cjlux/Banc-Mesure-Rotor/Docs/Images/Calibration-Magnet.png

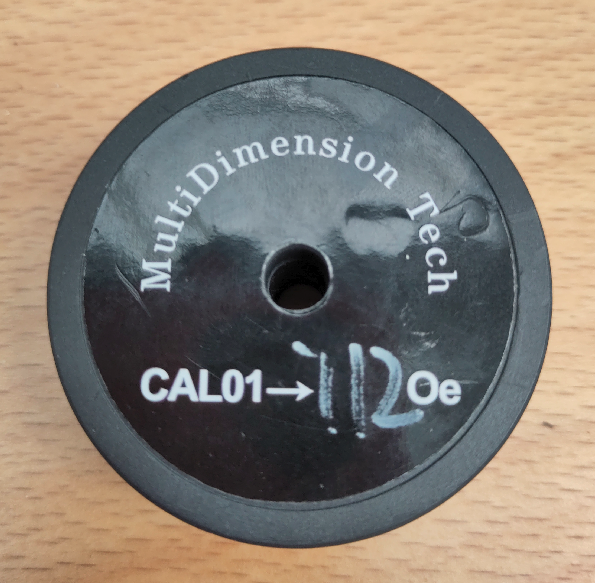
Docs/Images/Calibration-Magnet.png
