cjlux/Banc-Mesure-Rotor/Docs/Images/ROTOR_bench_overall-2.png

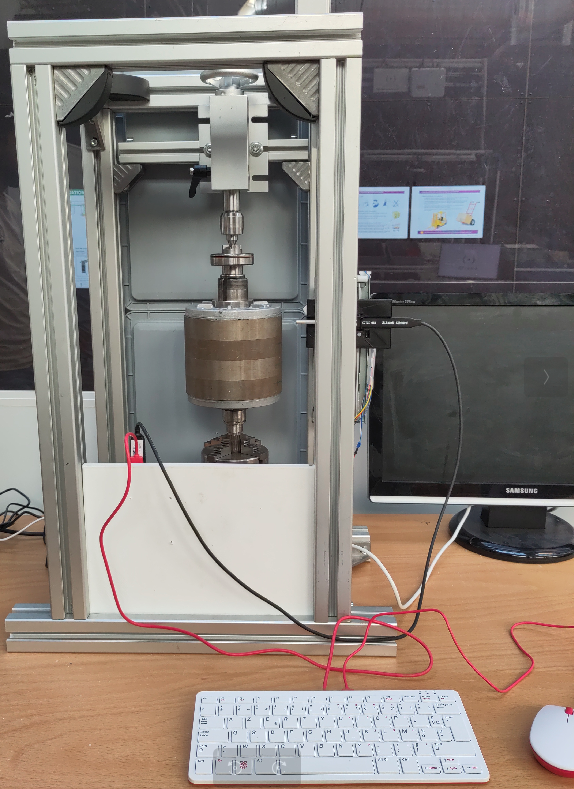
Docs/Images/ROTOR_bench_overall-2.png
