cjlux/Banc-Mesure-Rotor/README.md

# Banc-Mesure-Rotor
Banc de mesure du champ magnétique d'un rotor de moteur électrique
