cjlux/Banc-Mesure-Rotor/Docs/USB25103/USBMagV4.0.2/COM Port Optimizer Utility/Readme.txt

If the USB magnetometer driver is automatically installed by Microsoft Windows, it will be set to the default values specified by FTDI.  Run this utility to set the proper port latency and buffer sizes for USB Magnetometer fast operation.
