cjlux/Banc-Mesure-Rotor/Docs/USB25103/USBMagV4.0.2/Firmware/Three-axis/readme.txt

This firmware works for both Hall three-axis probes and TMR three-axis probes.
