cjlux/Banc-Mesure-Rotor/Docs/Sondes magnétiques.odt

Capteurs magnétiques / MULTI DIMENSION (MT)

https://www.dowaytech.com/en/sensor/usb_magnetometer.html

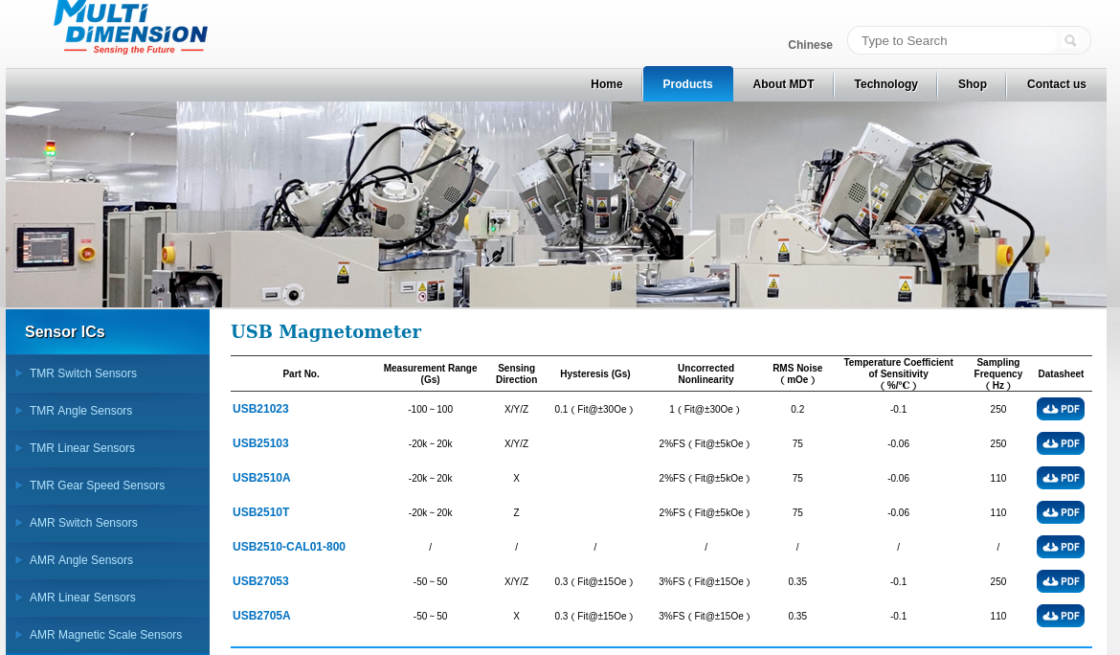
[picture p3: figure]
