cjlux/Banc-Mesure-Rotor/Docs/2024-11-19-15-50-06-532.jpg

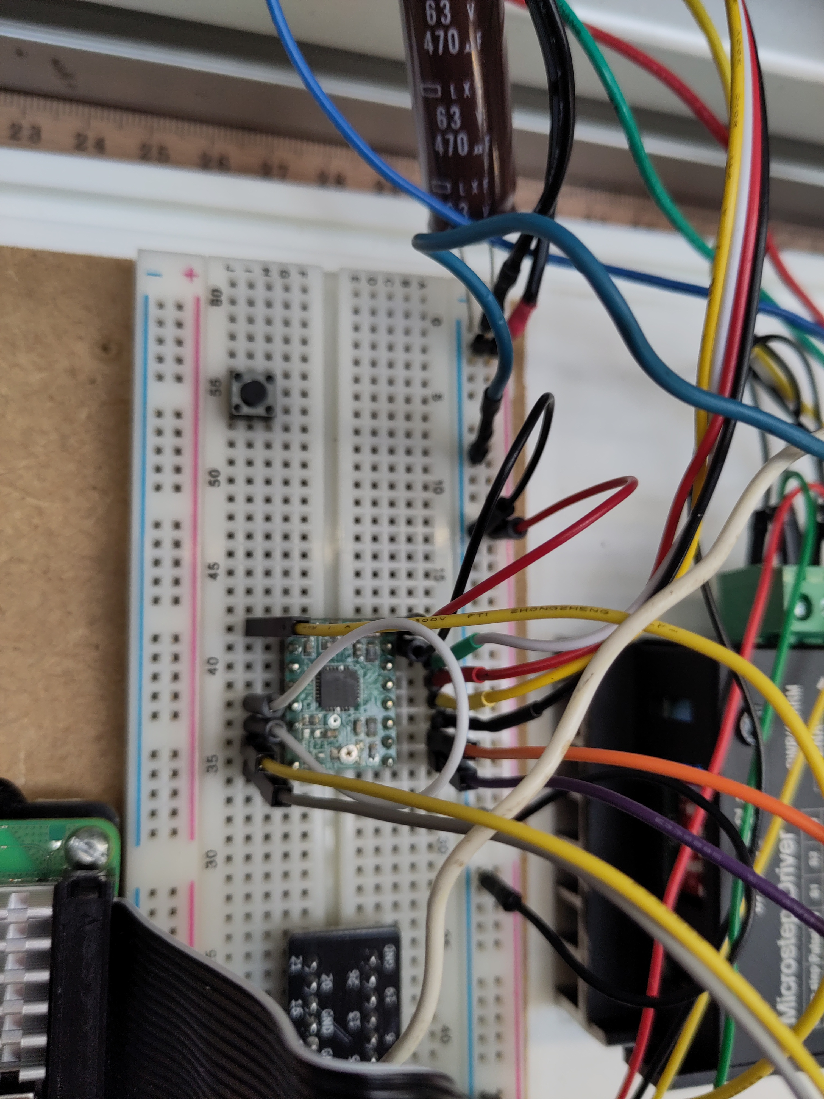
Docs/2024-11-19-15-50-06-532.jpg
