cjlux/Banc-Mesure-Rotor/Docs/2024-11-19-15-50-18-695.jpg

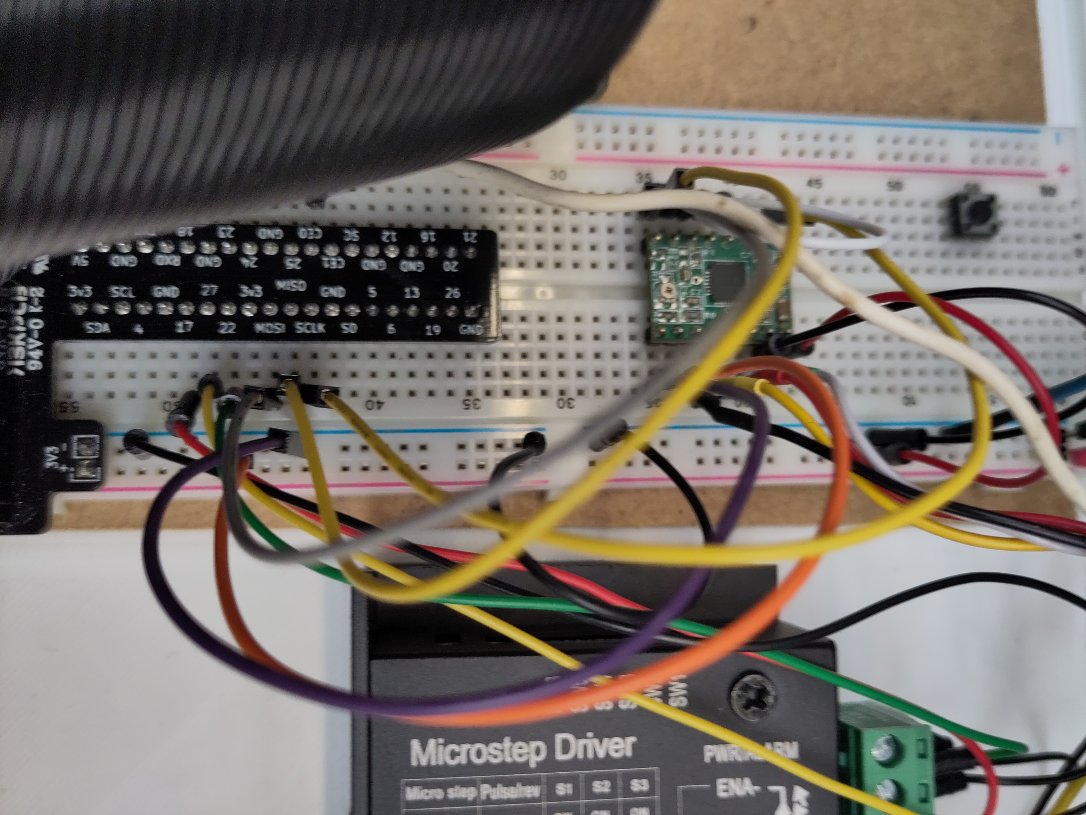
Docs/2024-11-19-15-50-18-695.jpg
