cjlux/Banc-Mesure-Rotor/Docs/2024-11-19-15-50-46-090.jpg

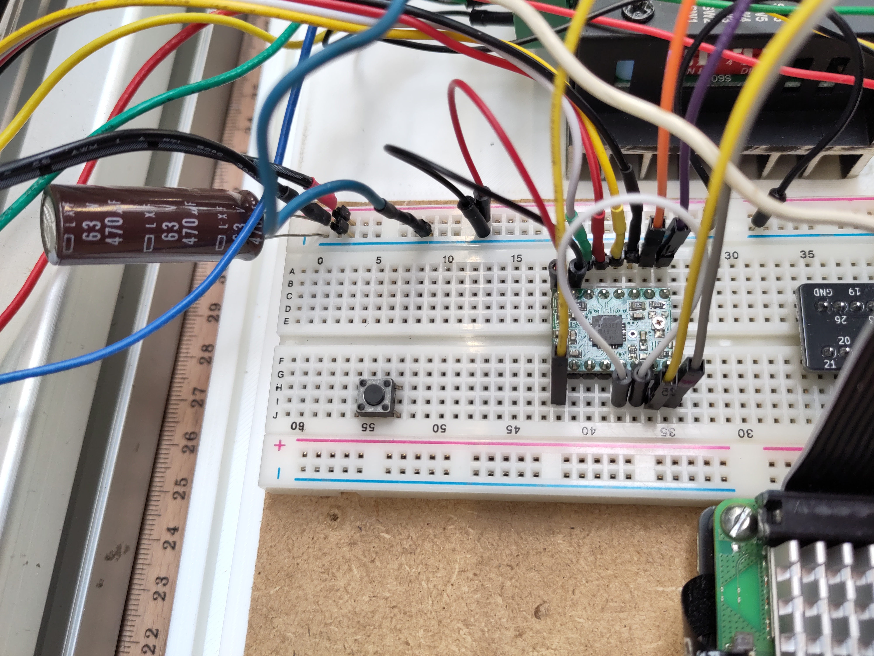
Docs/2024-11-19-15-50-46-090.jpg
