cjlux/Banc-Mesure-Rotor/Docs/2024-11-19-15-50-53-892.jpg

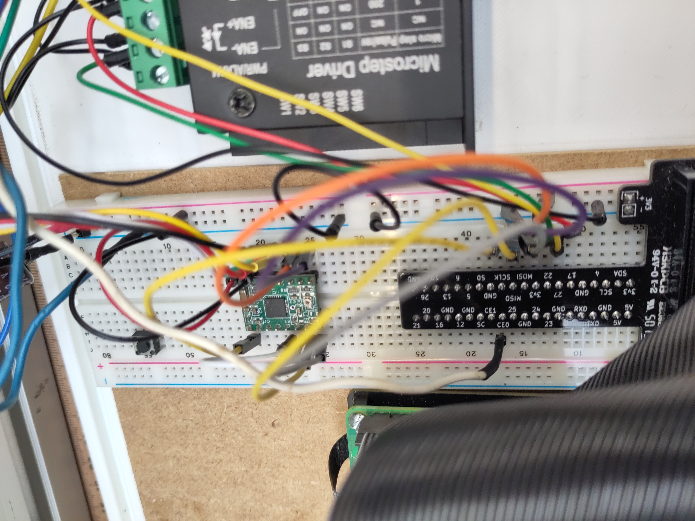
Docs/2024-11-19-15-50-53-892.jpg
