cjlux/Banc-Mesure-Rotor/Docs/Images/A4988.png

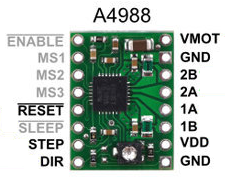
Docs/Images/A4988.png
