cjlux/Banc-Mesure-Rotor/Docs/Images/BlocMandrinXontrepointe.png

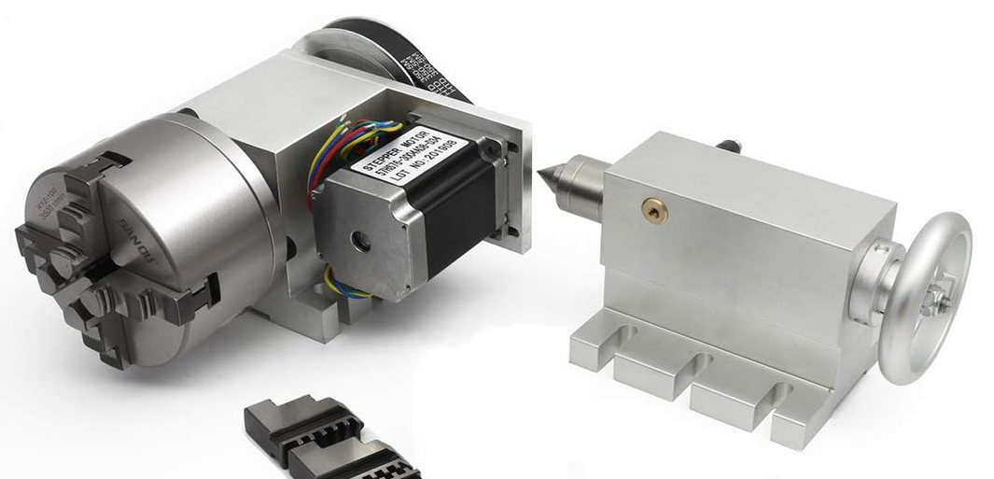
Docs/Images/BlocMandrinXontrepointe.png
