cjlux/Banc-Mesure-Rotor/Docs/Images/Chuck.png

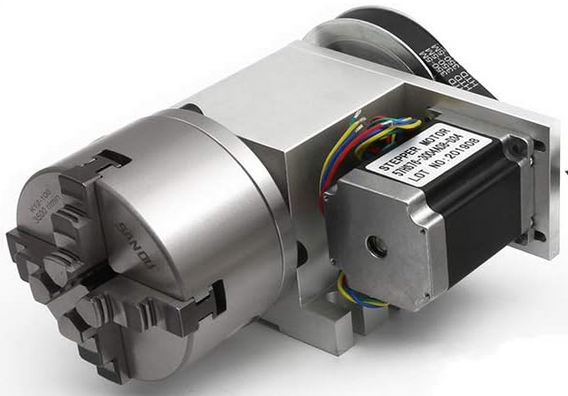
Docs/Images/Chuck.png
