cjlux/Banc-Mesure-Rotor/Docs/Images/Flowchart-1_2.png

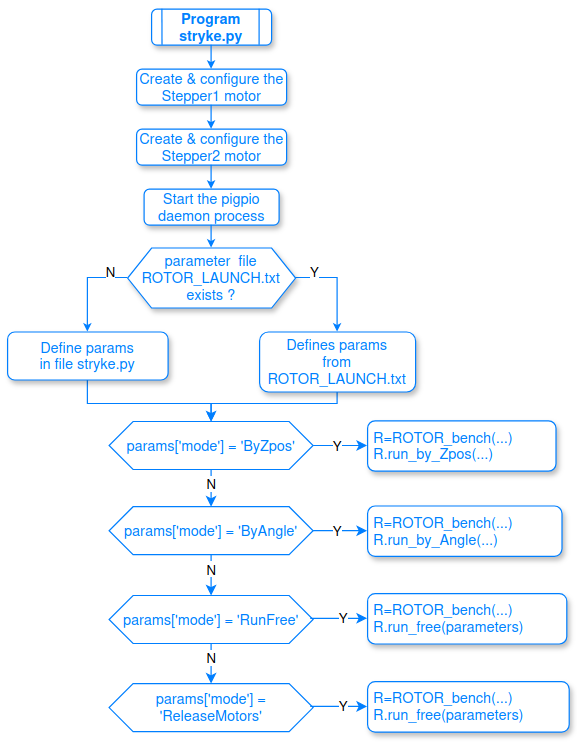
Docs/Images/Flowchart-1_2.png
