cjlux/Banc-Mesure-Rotor/Docs/Images/GUI-1_2.png

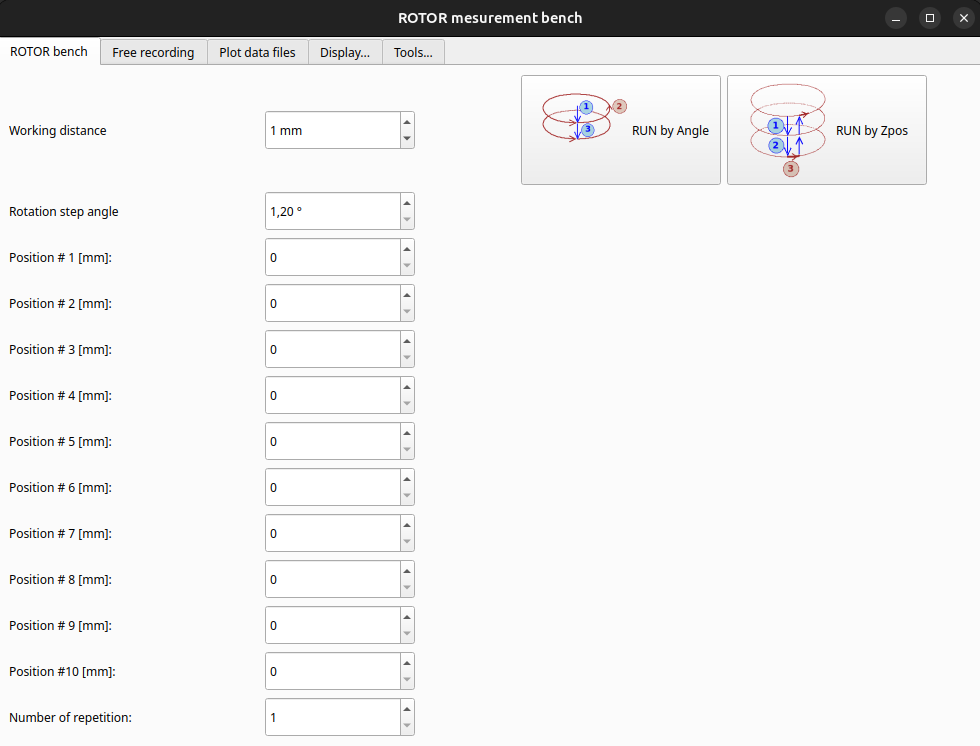
Docs/Images/GUI-1_2.png
