cjlux/Banc-Mesure-Rotor/Docs/Images/GUI-2.png

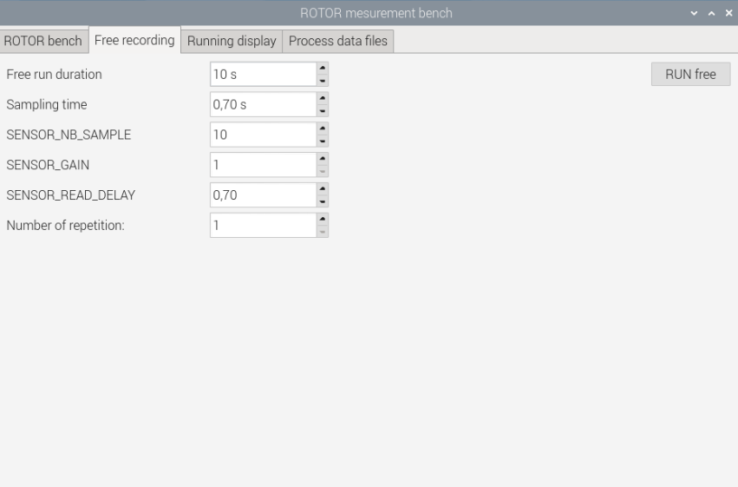
Docs/Images/GUI-2.png
