cjlux/Banc-Mesure-Rotor/Docs/Images/GUI-3-2.png

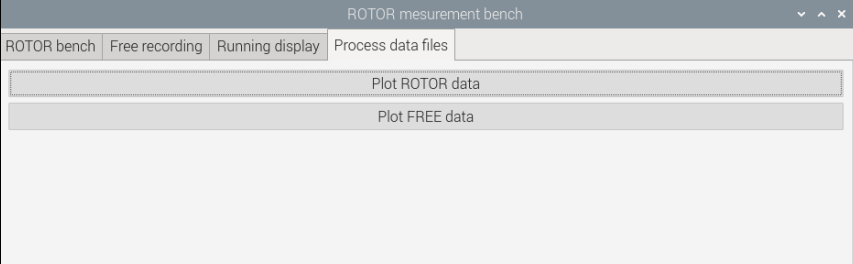
Docs/Images/GUI-3-2.png
