cjlux/Banc-Mesure-Rotor/Docs/Images/GUI-3-2_2.png

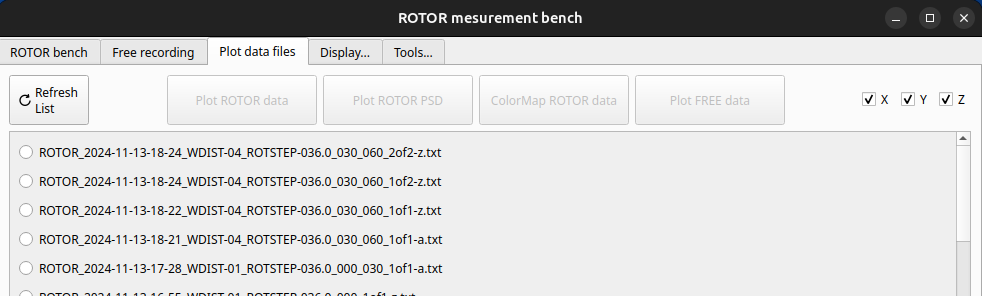
Docs/Images/GUI-3-2_2.png
