cjlux/Banc-Mesure-Rotor/Docs/Images/GUI-3.png

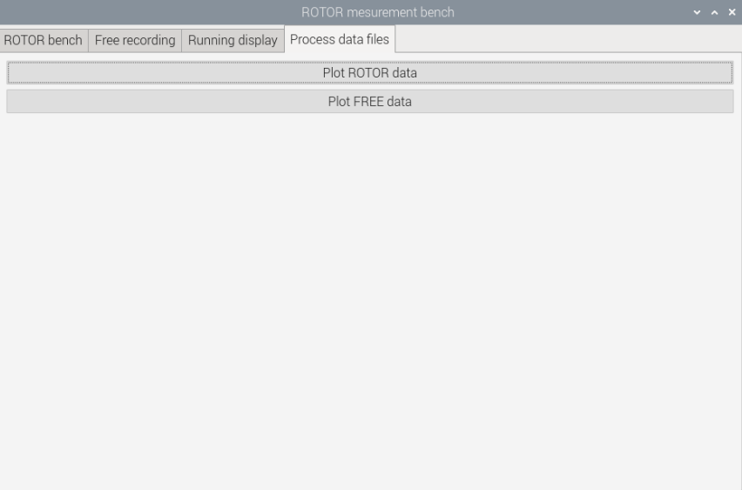
Docs/Images/GUI-3.png
