cjlux/Banc-Mesure-Rotor/Docs/Images/GUI_exple_plot_CMAP.png

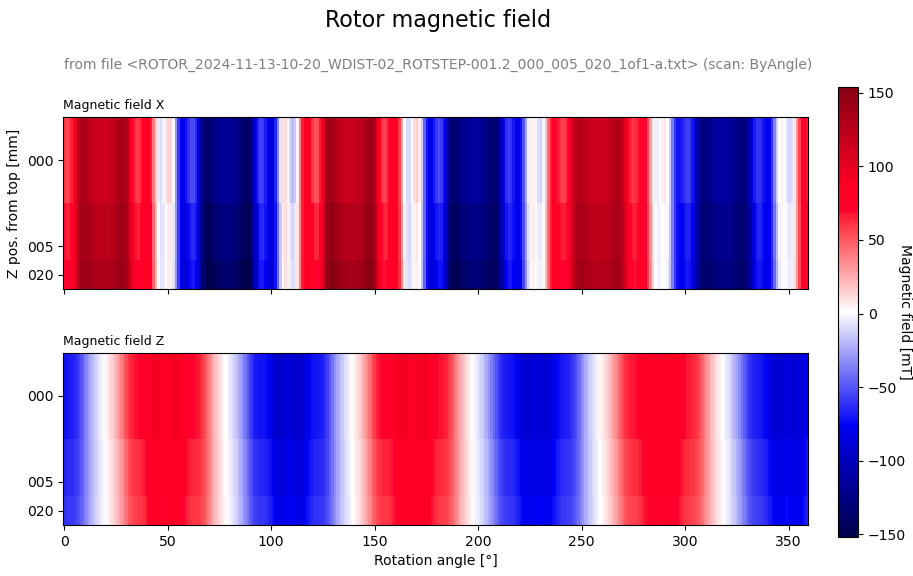
Docs/Images/GUI_exple_plot_CMAP.png
