cjlux/Banc-Mesure-Rotor/Docs/Images/GUI_exple_plot_PSD.png

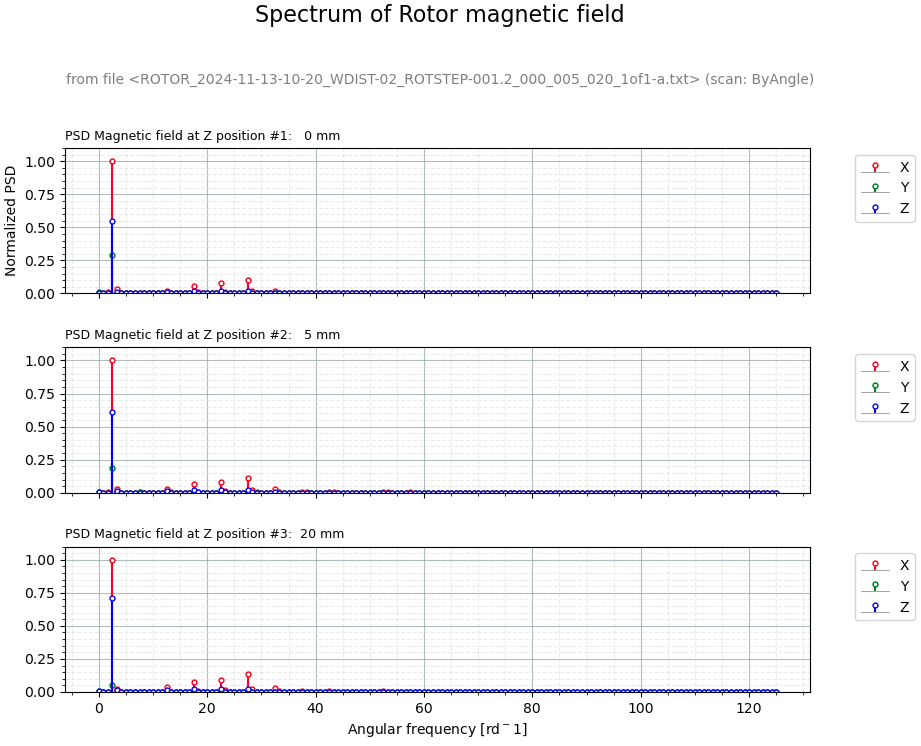
Docs/Images/GUI_exple_plot_PSD.png
