cjlux/Banc-Mesure-Rotor/Docs/Images/GUI_exple_plot_ROTOR.png

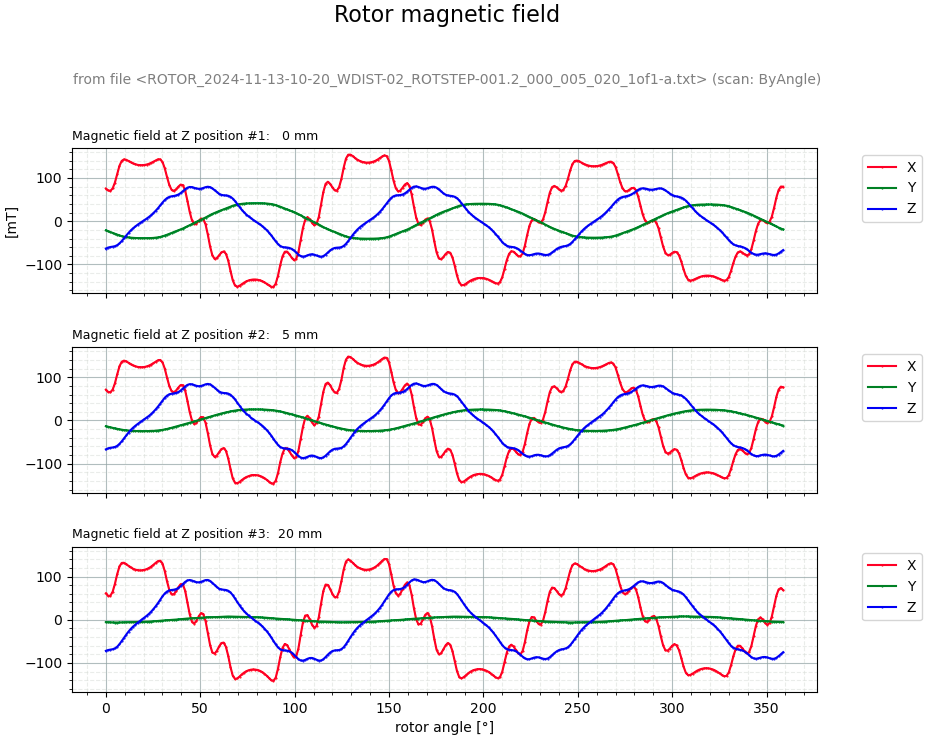
Docs/Images/GUI_exple_plot_ROTOR.png
