cjlux/Banc-Mesure-Rotor/Docs/Images/GUI_plot-FREE.png

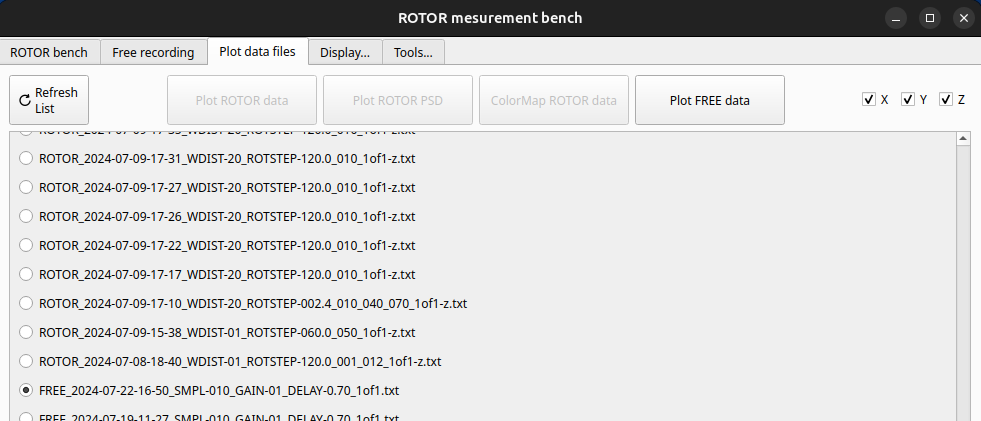
Docs/Images/GUI_plot-FREE.png
