cjlux/Banc-Mesure-Rotor/Docs/Images/GUI_plot-ROTOR.png

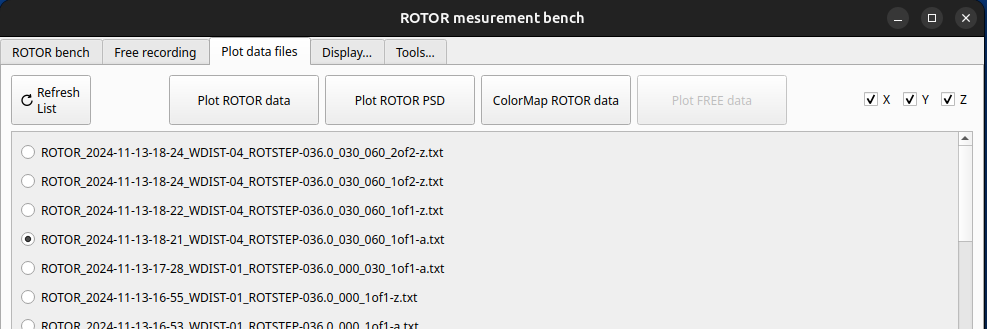
Docs/Images/GUI_plot-ROTOR.png
