cjlux/Banc-Mesure-Rotor/Docs/Images/Kit-PIMM699-2.png

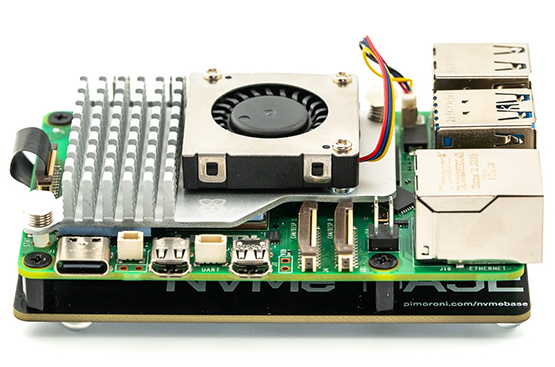
Docs/Images/Kit-PIMM699-2.png
