cjlux/Banc-Mesure-Rotor/Docs/Images/Kit-PIMM699-3.png

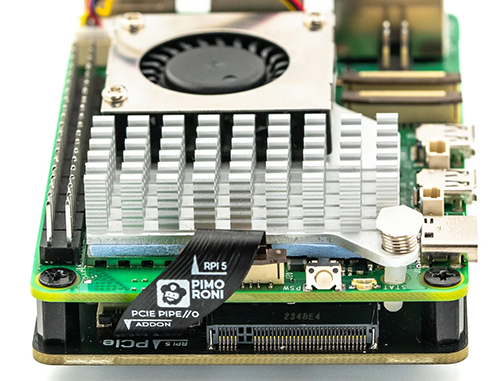
Docs/Images/Kit-PIMM699-3.png
