cjlux/Banc-Mesure-Rotor/Docs/Images/Kit-PIMM699.png

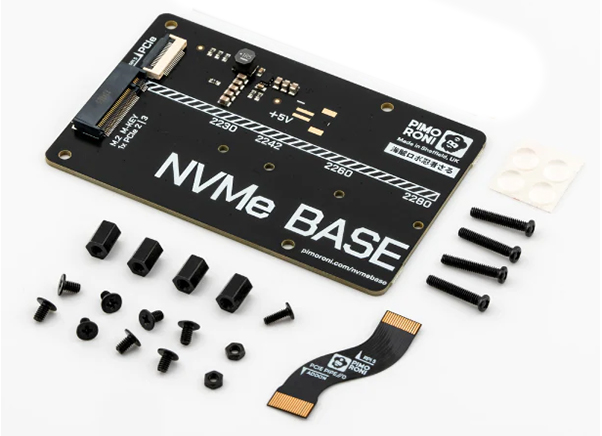
Docs/Images/Kit-PIMM699.png
