cjlux/Banc-Mesure-Rotor/Docs/Images/NEMA14.png

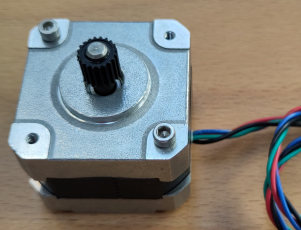
Docs/Images/NEMA14.png
