cjlux/Banc-Mesure-Rotor/Docs/Images/NEMA24.png

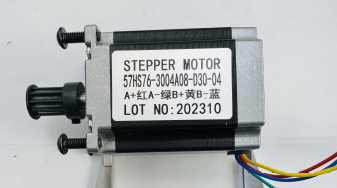
Docs/Images/NEMA24.png
