cjlux/Banc-Mesure-Rotor/Docs/Images/Plot_ROTOR.png

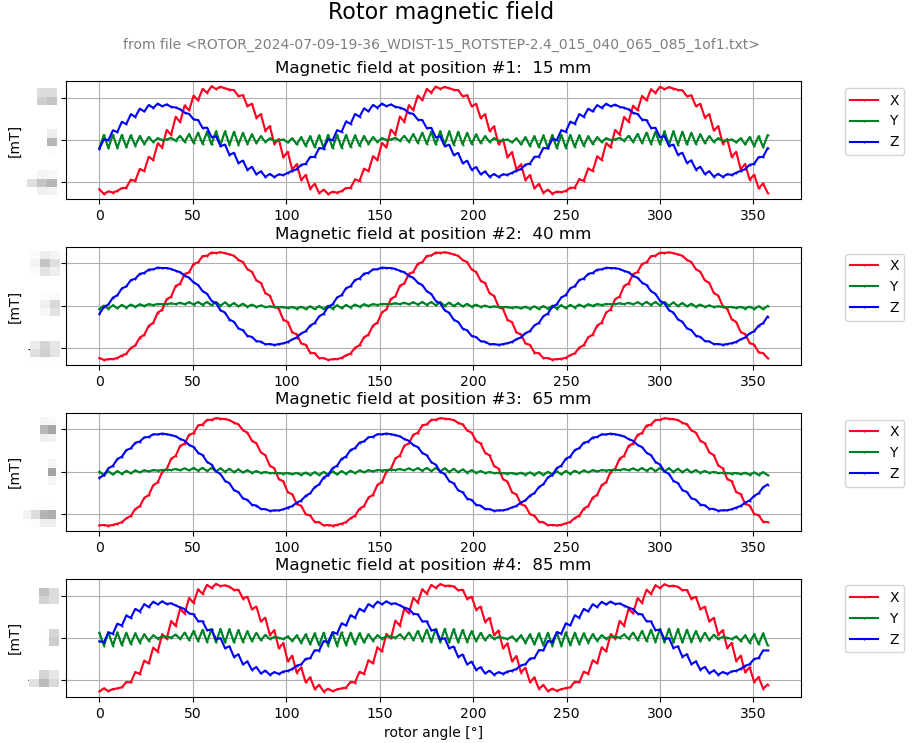
Docs/Images/Plot_ROTOR.png
