cjlux/Banc-Mesure-Rotor/Docs/Images/ROTOR_2024-11-07-17-33_WDIST-01_ROTSTEP-001.2_000_060_1of1-a_CMAP_XZ.png

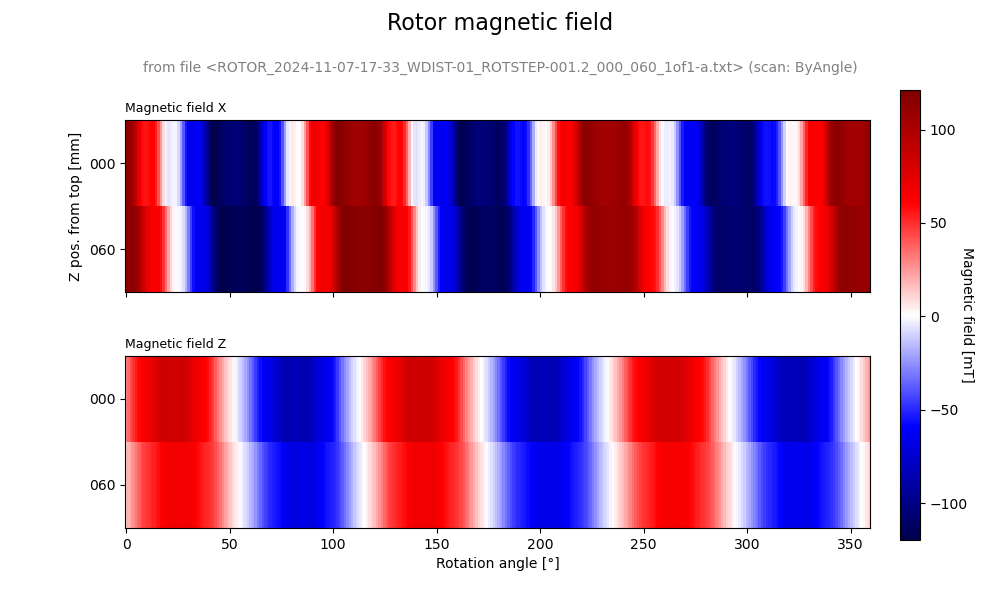
Docs/Images/ROTOR_2024-11-07-17-33_WDIST-01_ROTSTEP-001.2_000_060_1of1-a_CMAP_XZ.png
