cjlux/Banc-Mesure-Rotor/Docs/Images/ROTOR_bench-4.png

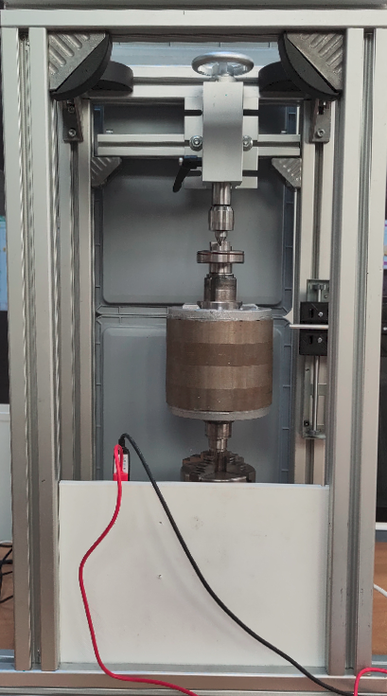
Docs/Images/ROTOR_bench-4.png
