cjlux/Banc-Mesure-Rotor/Docs/Images/ROTOR_bench_overall-1.png

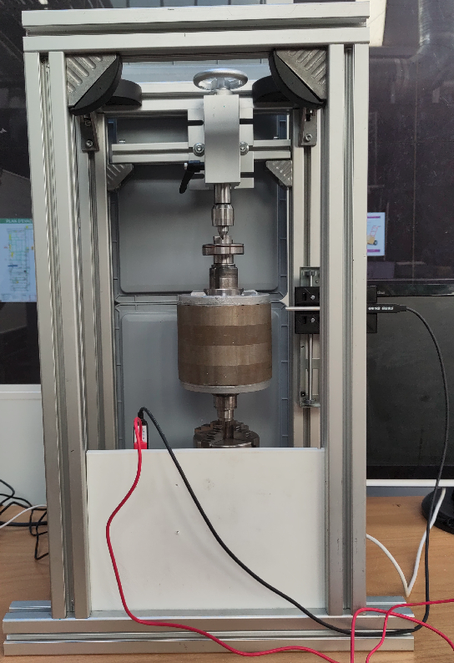
Docs/Images/ROTOR_bench_overall-1.png
