cjlux/Banc-Mesure-Rotor/Docs/Images/ROTOR_in_Chuck.png

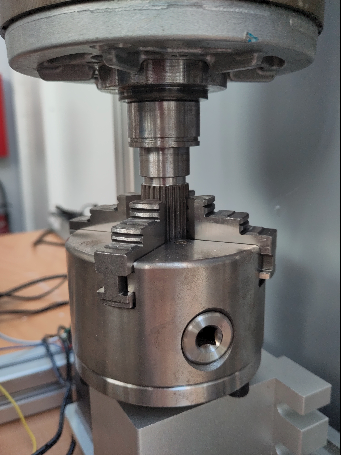
Docs/Images/ROTOR_in_Chuck.png
