cjlux/Banc-Mesure-Rotor/Docs/Images/ROTOR_in_Tailstock.png

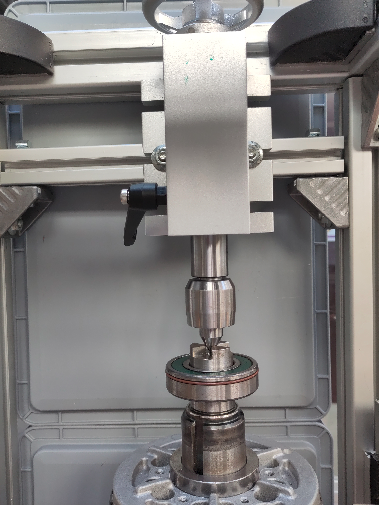
Docs/Images/ROTOR_in_Tailstock.png
