cjlux/Banc-Mesure-Rotor/Docs/Images/RPI4-plate.png

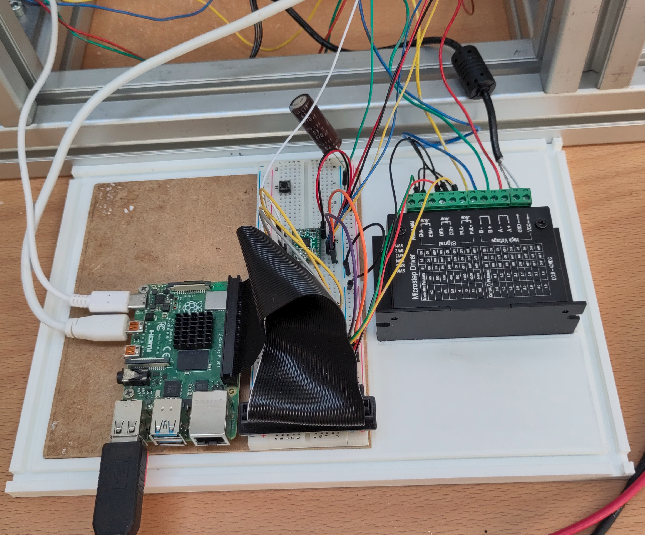
Docs/Images/RPI4-plate.png
