cjlux/Banc-Mesure-Rotor/Docs/Images/Sensor_Plate-1.png

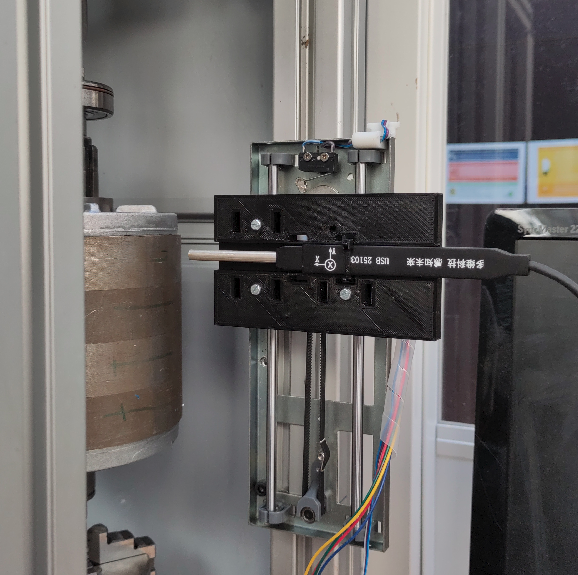
Docs/Images/Sensor_Plate-1.png
