cjlux/Banc-Mesure-Rotor/Docs/Images/Sensor_Plate-3.png

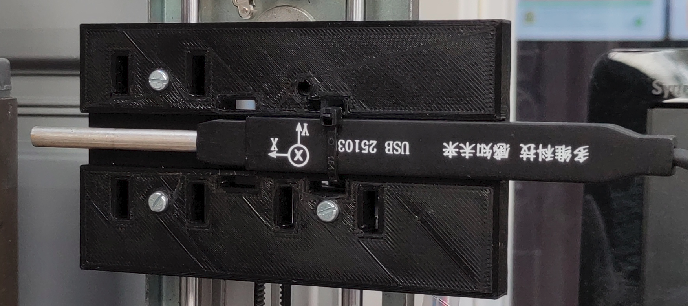
Docs/Images/Sensor_Plate-3.png
