cjlux/Banc-Mesure-Rotor/Docs/Images/Stepper-NAMA14.png

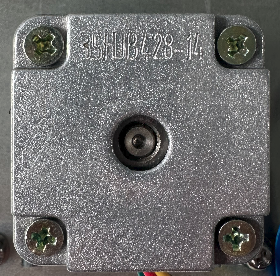
Docs/Images/Stepper-NAMA14.png
