cjlux/Banc-Mesure-Rotor/Docs/Images/Synoptic.png

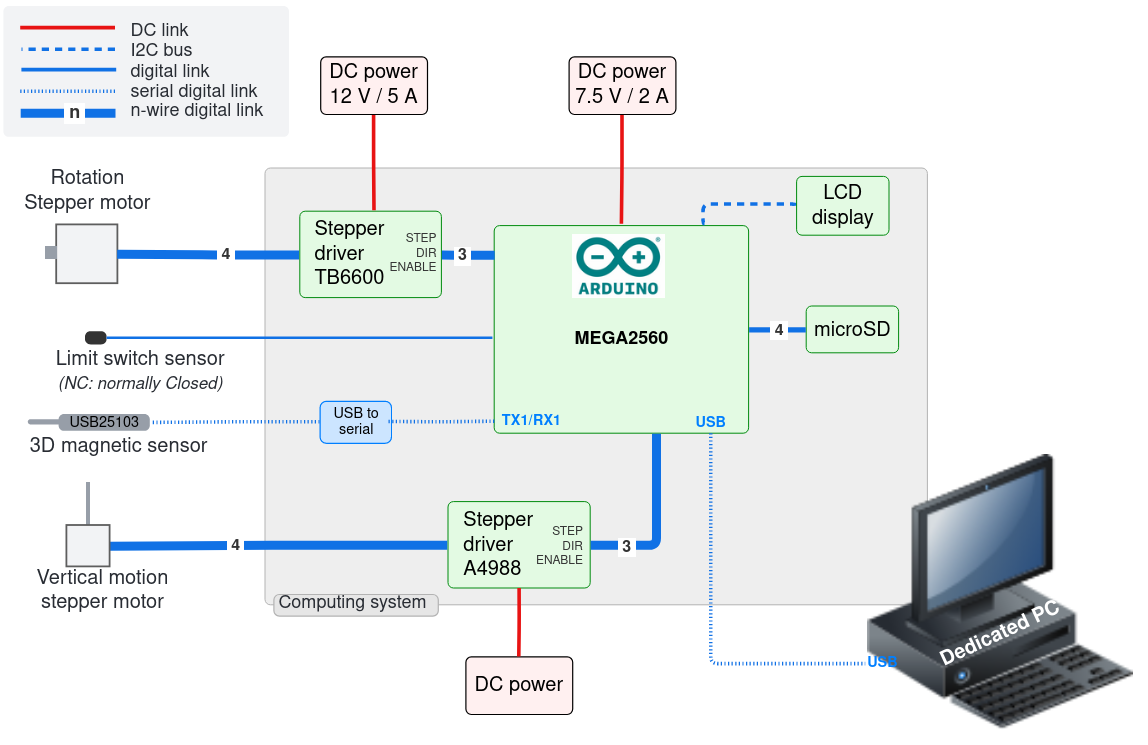
Docs/Images/Synoptic.png
