cjlux/Banc-Mesure-Rotor/Docs/Images/tailstock.png

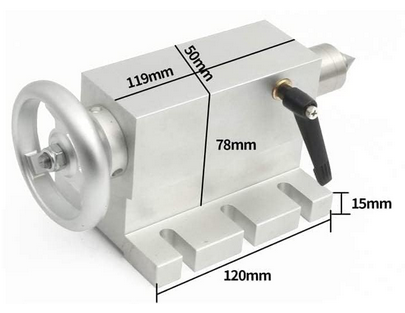
Docs/Images/tailstock.png
