cjlux/Banc-Mesure-Rotor/Docs/Images/USB25103.png

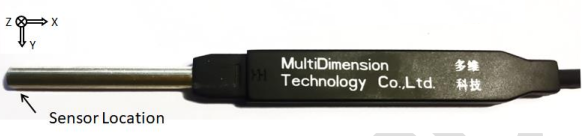
Docs/Images/USB25103.png
