cjlux/Banc-Mesure-Rotor/Docs/Images/USB27103-calib-axiale.png

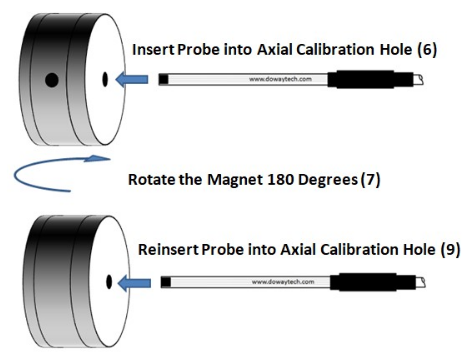
Docs/Images/USB27103-calib-axiale.png
