cjlux/Banc-Mesure-Rotor/Docs/Images/USB27103-calib-transverse.png

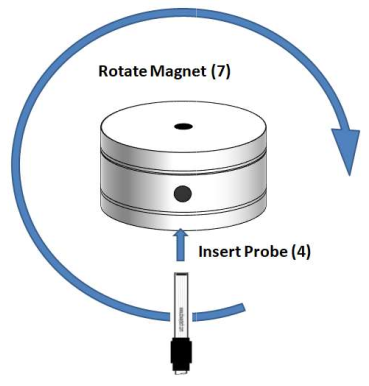
Docs/Images/USB27103-calib-transverse.png
