cjlux/Banc-Mesure-Rotor/Docs/Images/Zoom_NEMA14_connexion.png

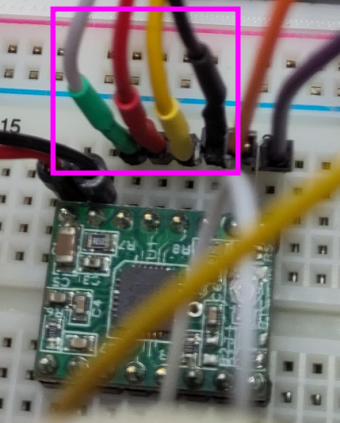
Docs/Images/Zoom_NEMA14_connexion.png
