cjlux/Banc-Mesure-Rotor/Docs/CAO/OverallPlate.FCStd

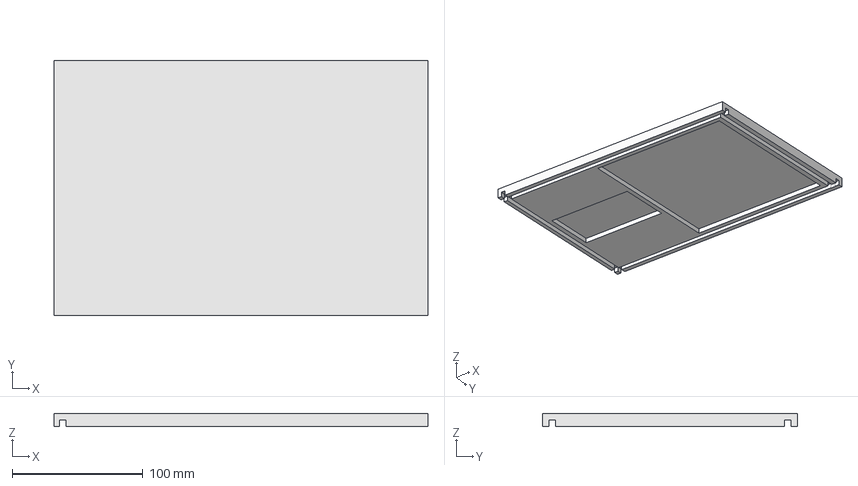
[picture p156: CAD file, 2024-07-17]
Docs/CAO/OverallPlate.FCStd
286.0 x 195.0 x 10.0 mm
