cjlux/Banc-Mesure-Rotor/Docs/CAO/MagneticProbePlate.FCStd

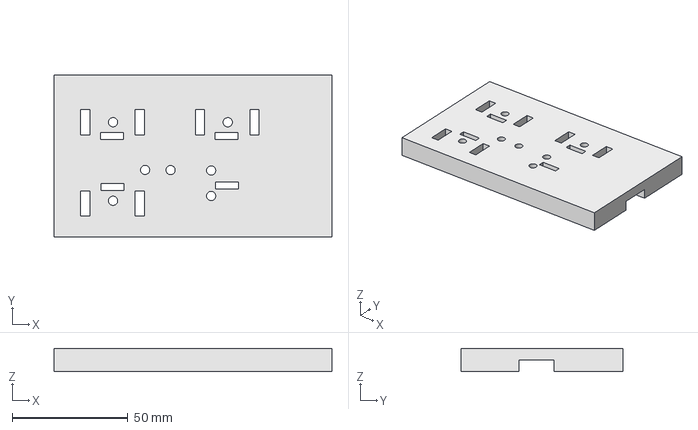
[picture p157: CAD file, 2024-07-17]
Docs/CAO/MagneticProbePlate.FCStd
120.0 x 70.0 x 10.0 mm
