cjlux/Banc-Mesure-Rotor/Old/Arduino_version/ProgTestArduino/Readme.md

Arduino demo code :
- LCD-I2C_16x2: (UNO & MEGA)elementary program do write data on the LCD display.
- RTC_LCD: (UNO & MEGA) Basic usage of the Real Time Clock module to display date & current time on the LCD display.
- MEGA_RTC_LCD_SD: (MEGA) Basic usage of the Real Time Clock to display date & current time on the LCD display plus create and write data file on the micro SD card.
- MEGA_RTC_LCD_SD_PAP: (MEGA) idem previous programm + driving the stepper mortor.
- stepperMotor_test : (UNO) test of a stepper motor with DIR, STEP & ENABLE signals.
- Test_Ref_Z_SteperMotor : (UNO & MEGA) Test Z motion with steeper motor on many Z positions.
- Test_Z_StepperMotor: (UNO & MEGA) Test Z motion with supward to reach the contact with the limit siwtch sensor.
- Tiny_RTC: (ANY) elementatry program to use the Real Time Clock module.
- UNO_PAP: (UNO) Test of the ROTOR stepper motor
- UNO_SD-CardInfo: (UNO) Display info on the SD card reader.
- UNO_SD-Files: (UNO) play with files on the SD card.
- UNO_SD-listfiles: (UNO) list files on the SD card.
- UNO_SD-ReadWrite: (UNO) elementatry program to read/write files on the SD card.
