cjlux/Banc-Mesure-Rotor/Docs/Images/USB27103-calibration.png

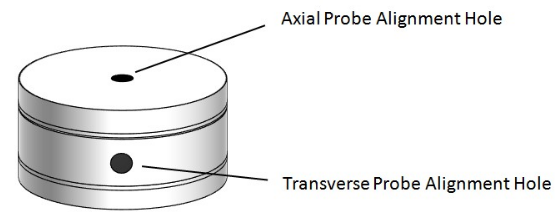
Docs/Images/USB27103-calibration.png
