cjlux/Banc-Mesure-Rotor/(list of files, drawings)

Other design files:
Docs/Diagrams/ElectricalScheme.fzz
