cjlux/Banc-Mesure-Rotor/ROTOR_bench/ROTOR_bench.py

#
# Copyright 2024-2025 Jean-Luc.CHARLES@mailo.com
#

import os
import numpy as np
import matplotlib.pyplot as plt
from serial import Serial
from time import sleep, time
from datetime import datetime
import sys, subprocess

import gpiod

from ROTOR_config import StepperMotor, Zaxis, Param
from Tools import uniq_file_name_ROTOR, uniq_file_name_FREE

class ROTOR_bench():

    def __init__(self, stepper1, stepper2, init_serial=True):

        self.stepper1 = stepper1    # the stepper motor for rotating the shaft
        self.stepper2 = stepper2    # the stepper motor for the sensorZ motion
        
        # GPIO in/out lines are defined in GPIOD_define_line() method:
        self.stepper1_DIR_line  = None
        self.stepper1_STEP_line = None
        self.stepper1_ENA_line  = None
        self.stepper2_DIR_line  = None
        self.stepper2_STEP_line = None
        self.stepper2_ENA_line  = None
        
        self.emergencyStopRequired = False
        self.serialPort = None      # The serial port connect to the USB link with the magnetic sensor.
        self.Z_pos_mm = []          # The list of the sensorZ positions, the first one is 0.
        
        # Instanciate the RPi GPIO driver with the 'gpiod' module:
        self.gpio_chip = gpiod.Chip('gpiochip4')

        self.GPIOD_define_lines()
        self.GPIOD_config_lines()
        self.GPIOD_init_lines()

        if init_serial:
            # open the seriallink with the sensor:
            self.open_Serial(5)
            if self.serialPort is None:
                print('[ERROR] cannot open any USB port, tchao!')
                sys.exit()

            # noww let's configure the magnetic sensor:
            ret = self.config_USBsensor()
            if ret !=0:
                print('[ERROR] while configuring the USBsensor, tchao!')
                sys.exit()
            else:
                print('[INFO] Sensor configuration OK')

            # Send someunused command to clean the serial buffer:
            self.serialPort.write(b'HI')
            sleep(1)
            self.serialPort.read_all()

            # Now get the sensor calibration data after the sensor calibration:
            self.serialPort.write(b'PC')
            sleep(1)
            data = self.serialPort.read_all().decode().replace('\r', '')
            print('[INFO] Configuration of the sensor USB25103:')
            print(data)
            self.calibration_data = '# ' + data.replace('\n', '\n# ') +'\n'

    def open_Serial(self, timeout:int = 1):
        '''
        To open the serial link to the magnetic sensor.
        '''
        listUSBports = ["/dev/ttyUSB0", "/dev/ttyUSB1"]
        serialPort = None
        for port in listUSBports:
            try:
                print(f"[INFO] Trying to open {port}")
                serialPort = Serial(port, baudrate=115200, timeout=timeout)
                break
            except:
                continue
        if serialPort is None:
            return
        self.serialPort = serialPort
        
        # read the magnetic sensor banner:
        sleep(3)
        data = self.serialPort.read_all().decode().strip()            
        print(f"[INFO] Found:\n{data}\n[INFO] Sound good !")

    def config_USBsensor(self):
        if self.serialPort is None:
            print('[ERROR] SeialPort is not opened, cannot configure the USBsensor')
            return -1
        self.serialPort.write(f"NS {Param['SENSOR_NB_SAMPLE']}".encode('ascii'))
        sleep(0.5)
        self.serialPort.write(f"PG {Param['SENSOR_GAIN']}".encode('ascii'))
        return 0
            
    def GPIOD_define_lines(self):
        ''' To define the needed RPi GPIO in/out lines.'''
        
        self.stepper1_DIR_line  = self.gpio_chip.get_line(self.stepper1.GPIO_DIR)
        self.stepper1_STEP_line = self.gpio_chip.get_line(self.stepper1.GPIO_STEP)
        self.stepper1_ENA_line  = self.gpio_chip.get_line(self.stepper1.GPIO_ENA)

        self.stepper2_DIR_line  = self.gpio_chip.get_line(self.stepper2.GPIO_DIR)
        self.stepper2_STEP_line = self.gpio_chip.get_line(self.stepper2.GPIO_STEP)
        self.stepper2_ENA_line  = self.gpio_chip.get_line(self.stepper2.GPIO_ENA)

        self.limit_switch_line  = self.gpio_chip.get_line(Zaxis.GPIO_LimitSwitch.value)
        
    def GPIOD_config_lines(self):
        ''' To parameter RPi GPIO lines as Input or Ouput.'''
        # set the stepper1 lines as Outputs:
        self.stepper1_DIR_line.request(consumer="stepper1_DIR",  type=gpiod.LINE_REQ_DIR_OUT)
        self.stepper1_STEP_line.request(consumer="stepper1_STEP", type=gpiod.LINE_REQ_DIR_OUT)
        self.stepper1_ENA_line.request(consumer="stepper1_ENA",  type=gpiod.LINE_REQ_DIR_OUT)
        
        # set the stepper2 lines as Outputs:
        self.stepper2_DIR_line.request(consumer="stepper2_DIR",  type=gpiod.LINE_REQ_DIR_OUT)
        self.stepper2_STEP_line.request(consumer="stepper2_STEP", type=gpiod.LINE_REQ_DIR_OUT)
        self.stepper2_ENA_line.request(consumer="stepper2_ENA",  type=gpiod.LINE_REQ_DIR_OUT)
        
        # The limit switch sensor is normally closed, connected between GND and RPi pinLimitSwitch.
        # pinLimitSwitch is set as INPUT pulled up to tge 5V. Normally the input is connected to GND
        # du to the limit switch; and when the switch is pressed the input goes to 5V (HIGH).
        self.limit_switch_line.request(consumer="Limit Switch",  type=gpiod.LINE_REQ_DIR_IN, flags=gpiod.LINE_REQ_FLAG_BIAS_PULL_UP)

    def GPIOD_init_lines(self):
        ''' To initialize the RPi GPIO output lines.'''

        self.stepper1_DIR_line.set_value(0)
        self.stepper1_ENA_line.set_value(1) # disable torque
        self.stepper1_STEP_line.set_value(0)
        
        self.stepper2_DIR_line.set_value(0)
        self.stepper2_ENA_line.set_value(1) # disable torque
        self.stepper2_STEP_line.set_value(0)

    def write_header(self,
                     MODE:str,
                     file_name:str,
                     work_dist:float=None,
                     rot_step:float=None,
                     NBSTEP1:int=None,
                     Zpos:list=None):

        assert MODE in ("ByZPos", "FreeRun", "ByAngle")
        
        with open(file_name, "w", encoding="utf8") as fOut:

            # write calibration data:
            fOut.write(self.calibration_data)

            # write sensorparameters
            for k in Param.keys():
                if'SENSOR' in k: fOut.write(f'# {k}: {Param[k]} \n')

            if MODE in ("ByZPos", "ByAngle"):
                # Write header for a "by Zpos" measurement strategy:
                fOut.write(f'# working dist: {work_dist} mm\n')
                fOut.write(f'# Rotation step angle: {rot_step}°\n')
                nb_pos = len(Zpos)                    
                for n, p in enumerate(Zpos, 1):
                    fOut.write(f"# sensor pos #{n}: {p} mm\n")                
            
            if MODE == "ByZPos":
                # Write specific columns header:
                line = "# byPos\n# angle[°]"
                for n in range(1, nb_pos+1):
                    line += f"; X{n}_magn [mT]; Y{n}_magn [mT]; Z{n}_magn [mT]"
                fOut.write(line + '\n')

            elif MODE == "ByAngle":
                # Write specific columns header:
                line  = "# ByAngle\n# ZPos#; a[°]; X1_magn[mT]; Y1_magn[mT]; Z1_magn[mT]"
                fOut.write(line + '\n')
    
            elif MODE == "FreeRun":
                # write simplified header for "Free Run" mode:
                fOut.write('\n# Time[s]; Xmagn [mT]; Ymagn [mT]; Zmagn [mT];\n')            


    def Zref_sensor(self, hold_torque:bool = False, verbose:bool = False):
        '''
        To make the stepper motor move the sensor until it reaches the limit switch sensor
        '''
        print("[INFO] Stepper motor Z referencing...");

        # move upward:
        self.stepper2_DIR_line.set_value(0)

        # apply the motor holding torque:
        self.stepper2_ENA_line.set_value(0)

        #  the required revolution speed [revol/sec] and corresponding period:
        N_Hz  = 2 * Zaxis.Zref_velocity.value / (np.pi * self.stepper2.DIAM_MM
                                                 )
        T_sec = 1 / (N_Hz * self.stepper2.NB_STEP_PER_REVOL)
        if verbose: print(f"[INFO] N_Hz: {N_Hz:.2f}, T_ms: {T_sec*1e3:.2f}")

        limit_state = self.limit_switch_line.get_value()
        print(f'{limit_state=}')
        while limit_state != 1:
            # Send a pulse with period equals to Tms:
            t0 = time()
            self.stepper2_STEP_line.set_value(1)
            limit_state = self.limit_switch_line.get_value()
            self.stepper2_STEP_line.set_value(0)
            while True:
                if time() - t0 > T_sec: break

        if hold_torque == False: 
            # disable the motor holding torque:
            self.stepper2_ENA_line.set_value(1)

        if verbose: print("[INFO] OK !")
        return 0

    def Do_Zmove_sensor(self, curr_pos_mm:float, n:int, hold_torque:bool = False, verbose:bool = False):
        '''
        To move the sensor carriage along the Z axis.
        Parameters:
        - curr_pos_mm: the current position (in mm) of the sensor along the Z axis,
        - n: the rank of the Z position
        Returns: the new value of 'curr_pos_mm'.
        '''

        target_Z_pos = self.Z_pos_mm[n]
        # compute the distance of the move to do:
        dist = target_Z_pos - curr_pos_mm

        if verbose:
            mess = f"[INFO] Current pos is {curr_pos_mm} mm, moving to pos#{n} at {target_Z_pos} mm"
            mess += f" - dist: {dist} mm"
            if dist == 0: mess += " SKIPPING"
            print(mess)    

        # make the displacement for real: 
        # (Z_velocity & hold_stepper_torque are global variables)
        self.Zmove_sensor(dist, Zaxis.Z_velocity.value, hold_torque, verbose)

        # return the new value of the Z position
        return target_Z_pos

    def Zmove_sensor(self, dist_mm: int, speed_mm_per_sec:int, hold_torque:bool = False, verbose:bool = False):
        '''    
        To make the sensor cart move of 'dist_mm' upward if 'dist_mm' < 0, 
        downward if it is > 0. 
        '''

        if verbose: print(f"[INFO] Zmove_sensor, dist: {dist_mm} mm")

        # nothing to do if dist is null:
        if dist_mm == 0: return

        # Set the direction of move:
        if dist_mm > 0:
            self.stepper2_DIR_line.set_value(1)  # direction of move is downward:
        elif dist_mm < 0:
            self.stepper2_DIR_line.set_value(0)   # direction of move is upward:
            dist_mm = -dist_mm
            
        # the required revolution speed [revol/sec] and corresponding period:
        N_Hz  = 2. * speed_mm_per_sec / (np.pi *  self.stepper2.DIAM_MM)
        T_sec = 1 / (N_Hz * self.stepper2.NB_STEP_PER_REVOL)
        if verbose: print(f"[INFO] N_Hz: {N_Hz:.2f}, T_ms: {T_sec*1e3:.2f}")

        # the required number of steps: 
        nb_step = int(2. * 180 * dist_mm / (self.stepper2.STEPPER_ANGLE * np.pi * self.stepper2.DIAM_MM))

        # Let's do the job:

        # apply the motor holding torque:
        self.stepper2_ENA_line.set_value(0)

        self.stepper2_STEP_line.set_value(0)
        for n in range(nb_step):
            t0 = time()
            # Send a pulse with period equals to Tms:
            self.stepper2_STEP_line.set_value(1)
            sleep(20e-6)
            self.stepper2_STEP_line.set_value(0)
            while True:
                if time() - t0 > T_sec: break

        if hold_torque == False: 
            # disable the motor holding torque:
            self.stepper2_ENA_line.set_value(1)       

    def Do_sensor_measurement(self, fake=False):
        '''
        Do the measurement of the magnetic field. If fake is True, randomvalues are returned
        (useful fordebugging).
        returns the string 'line' completed with the values of the magnetic field.
        '''
        if fake:
            #  make tke measure (simulations only for now):
            X = np.random.randint(1, 2000)/1.2
            Y = np.random.randint(1, 2000)/1.2
            Z = np.random.randint(1, 2000)/1.2
        else:
            # send a 'Read Manual' (RM) command to the sensor:
            self.serialPort.write(b'RM')
            sleep(Param['SENSOR_READ_DELAY'])
            data = self.serialPort.read_all()
            data = data.decode().replace('\r','').split('RD')[-1].strip()
            X, Y, Z = map(float, data.split(','))
            
        return X, Y, Z

    def EmergencyStop(self): 
        print("[INFO] EMERGENCY-STOP required")
        self.emergencyStopRequired = True
        self.Stop_ROTOR_Bench()

    def Stop_ROTOR_Bench(self, verbose=True):
        '''
        This function is called when the emergency-stop button is pressed.
        It should stop the motors and left the ROTOR bench in s safe state.
        '''
        self.stepper1_ENA_line.set_value(1)     # release the torque of the shaft stepper motor
        self.stepper2_ENA_line.set_value(1)     # release the torque of the Z stepper motor
        if verbose: print("[INFO] All motor released")
        
    def run_free(self, params):
        '''
        To measure continuously the magnetic field ans write the data in a CALIB_...txt file.
        '''
        MODE = "FreeRun"
        
        duration = params["DURATION"]
        sampling = params['SAMPLING']
        
        SAMPLE = params.get('SENSOR_NB_SAMPLE', params['SENSOR_NB_SAMPLE'])
        GAIN = params.get('SENSOR_GAIN', params['SENSOR_GAIN'])
        SENSOR_READ_DELAY = params.get('SENSOR_READ_DELAY', params['SENSOR_READ_DELAY'])
        
        nb_repet  = params['NB_REPET']
        
        # release motors:
        self.Stop_ROTOR_Bench()
        
        now = datetime.now() # current date and time

        for repet in range(1, nb_repet+1):

            # Define the unique file name for the data
            fileName = uniq_file_name_FREE(now, duration, sampling, SAMPLE, GAIN, SENSOR_READ_DELAY,  (repet, nb_repet))
          
            # write the header lines in the data rotor file
            self.write_header(MODE, fileName)
          
            # write the header lines in the data file
            with open(fileName, "a", encoding="utf8") as fOut:
              
                # Send unused command to clean the buhher:
                self.serialPort.write(b'HI')
                sleep(1)
                self.serialPort.read_all()
                  
                t0 = time()
                while True:
                    t1 = time()

                    # send a 'Read Manual' (RM) command to the sensor:
                    self.serialPort.write(b'RM')
                    sleep(SENSOR_READ_DELAY)
                    data = self.serialPort.read_all().decode().replace('\r','')
                    t_read = time()- t0
                    data = data.split('RD')[-1].strip()
                    X, Y, Z = map(float, data.split(','))
                    coeff = Param['SENSOR_Oe_mT']
                    X *= coeff
                    Y *= coeff
                    Z *= coeff

                    line = f'{t_read:5.2f};{X:12.6f};{Y:12.6f};{Z:12.6f}\n'
                    fOut.write(line)
                    fOut.flush()
                    print(f'[DATA] {line}', end="")

                    # set measurement time period to 1 sec:
                    while True:
                        if time() - t1 >= sampling: break

                    # quit the loop when the elapsed time reaches duration:
                    if time() - t0 >= duration: break
            
        print("[INFO] end run_free")  
        self.serialPort.close()
        
    def run_by_ZPos(self, parameters:dict, verbose:bool =False):
        '''Make the measurement: for each angle position the magnetic sensor is moved
           vertically along the Z axis to explore the magnetic field at the different Zpos.
        '''
        MODE = "ByZPos"
        
        work_dist = parameters["WORK_DIST"]
        rot_step  = parameters['ROT_STEP_DEG']
        Zpos_mm   = parameters['Z_POS_MM']
        nb_repet  = parameters['NB_REPET']

        nb_sensor_pos = len(Zpos_mm)
        self.Z_pos_mm = parameters["Z_POS_MM"]
        
        NBSTEP1  = round(rot_step * self.stepper1.RATIO / self.stepper1.STEPPER_ANGLE)    
        T_stepper1_sec = 1 / (self.stepper1.NB_REVOL_PER_SEC * self.stepper1.NB_STEP_PER_REVOL);
        if verbose:
            print(f'[INFO] ROT_STEP_DEG: {rot_step}, NBSTEP1: {NBSTEP1}, T_stepper1_sec:{T_stepper1_sec:.3f}')
        
        now = datetime.now() # current date and time

        print(f'{Zpos_mm=}')

        for repet in range(1, nb_repet+1):
          
            # Define the unique file name for the data
            fileName = uniq_file_name_ROTOR(now, work_dist, rot_step, Zpos_mm, (repet, nb_repet), MODE)

            # write the header lines in the datarotor file
            self.write_header(MODE, fileName, work_dist, rot_step, NBSTEP1, Zpos_mm)

            # Enable the shaft stepper motor torque:
            self.stepper1_ENA_line.set_value(0) 

            # open the data file with the uniq name:
            fOut = open(fileName, "a", encoding="utf8")

            # scan angle from 0 to 360°:
            count = 0
            curr_Zpos_mm = 0

            # Send unused command to clean the buffer:
            self.serialPort.write(b'HI')
            sleep(1)
            self.serialPort.read_all()

            while True:
                t0 = time()
                angle = rot_step*count
                if angle >= 360: break

                # Now make the mmagnetic field measurement for all the positions of the sensor:
                line = f'{angle:5.1f}'

                Zpos_move_required = count % Zaxis.ZREF_EVERY_ROTSTEP.value

                if Zpos_move_required == 0: curr_Zpos_mm = self.Zref_sensor(hold_torque=True)

                go = count % 2
                if go == 0:
                    start, stop, step = 0, nb_sensor_pos, 1
                else:
                    start, stop, step = nb_sensor_pos-1, -1, -1

                # Move the sensor donward along Z axis:
                for n in range(start, stop, step):

                    # Move the sensor to the right Z position:
                    curr_Zpos_mm = self.Do_Zmove_sensor(curr_Zpos_mm, n, hold_torque=True)

                    # Make the sensor measuremnts:
                    X, Y, Z = self.Do_sensor_measurement();
                    coeff = Param['SENSOR_Oe_mT']
                    X *= coeff
                    Y *= coeff
                    Z *= coeff
                    line += f';{X:12.6f};{Y:12.6f};{Z:12.6f}'

                # Write data:
                fOut.write(line + '\n')
                fOut.flush()
                print("[DATA] " + line)
                
                # Make the stepper motor do the steps to turn the ROTOR of the 'rotor_step' value:
                for i in range(0, NBSTEP1):
                    top = time()
                    self.stepper1_STEP_line.set_value(1)
                    sleep(0.001)
                    self.stepper1_STEP_line.set_value(0)
                    while True:
                        if time() - top > T_stepper1_sec: break
              
                # If there is only one Z position for the sensor, wait 1 seconde:
                if nb_sensor_pos == 1:
                    t1 = time();
                    while t1 - t0 < 1:
                        t1 = time()

                count += 1;

        # release all motor torques:
        self.Stop_ROTOR_Bench()

        # close the data file:
        fOut.close();
        
        print("[INFO] end of Run_by_ZPos")    
        self.serialPort.close()

    def run_by_Angle(self, parameters:dict, verbose:bool =False):
        '''Make the measurements: for each Zpos the rotor is rotated by a step angle
           to explore the magnetic field at the different angle positions.
           Once a full rotation is achieved, the sensor moves to the next Zpos
           and the rotor is rotated again...
        '''

        MODE = "ByAngle"
        
        work_dist = parameters["WORK_DIST"]
        rot_step  = parameters['ROT_STEP_DEG']
        Zpos_mm   = parameters['Z_POS_MM']
        nb_repet  = parameters['NB_REPET']

        nb_sensor_pos = len(Zpos_mm)
        nb_angle_pos  = int(360 / rot_step)
        self.Z_pos_mm = parameters["Z_POS_MM"]
        
        NBSTEP1  = round(rot_step * self.stepper1.RATIO / self.stepper1.STEPPER_ANGLE)    
        T_stepper1_sec = 1 / (self.stepper1.NB_REVOL_PER_SEC * self.stepper1.NB_STEP_PER_REVOL);
        if verbose:
            print(f'[INFO] ROT_STEP_DEG: {rot_step}, NBSTEP1: {NBSTEP1}, T_stepper1_sec:{T_stepper1_sec:.3f}')
        
        now = datetime.now() # current date and time

        for repet in range(1, nb_repet+1):
          
            # Define the unique file name for the data
            fileName = uniq_file_name_ROTOR(now, work_dist, rot_step, Zpos_mm, (repet, nb_repet), MODE)

            # write the header lines in the data rotor file
            self.write_header(MODE, fileName, work_dist, rot_step, NBSTEP1, Zpos_mm)
          
            # Enable the shaft stepper motor torque:
            self.stepper1_ENA_line.set_value(0) 

            # open the data file with the uniq name:
            fOut = open(fileName, "a", encoding="utf8")

            # Start the sensor position at top:
            curr_Zpos_mm = 0

            # Send unused command to clean the buffer:
            self.serialPort.write(b'HI')
            sleep(1)
            self.serialPort.read_all()

            self.Zref_sensor(hold_torque=True)
            
            # Loop on the sensor Zpos:
            for n in range(0, nb_sensor_pos):         
                  
                # Move the sensor to the right Z position:
                curr_Zpos_mm = self.Do_Zmove_sensor(curr_Zpos_mm, n, hold_torque=True)

                # scan angle from 0 to 360°:
                count = 0

                # The loop on the rotor angle (make a complete rotation)
                while True:

                    # Now make the magnetic field measurement for all the positions of the sensor:
                    line = f'{n:2d};'

                    angle = rot_step*count
                    if angle >= 360: break
                  
                    # Make the sensor measuremnts:
                    X, Y, Z = self.Do_sensor_measurement();
                    coeff = Param['SENSOR_Oe_mT']
                    X *= coeff
                    Y *= coeff
                    Z *= coeff
                    values = f'{angle:5.1f};{X:12.6f};{Y:12.6f};{Z:12.6f}'
                    line += values

                    print("[DATA] " + values)

                    # Make the stepper motor do the steps to turn the ROTOR of the 'rotor_step' value:
                    for i in range(0, NBSTEP1):
                        top = time()
                        self.stepper1_STEP_line.set_value(1)
                        sleep(0.001)
                        self.stepper1_STEP_line.set_value(0)
                        while True:
                            if time() - top > T_stepper1_sec: break

                    count += 1

                    # Write data:
                    fOut.write(line + '\n')
                    fOut.flush()
                  
        # release all motor torques:
        self.Stop_ROTOR_Bench()
          
        # close the data file:
        fOut.close();

        print("END of Run_by_Angle")  
        self.serialPort.close()

if __name__ == "__main__":

    print("Nothing to do here !!!")

    
