cjlux/Banc-Mesure-Rotor/(commit log)

2024-05-22 Mettre à jour Rotor magnetic field measurement bench.drawio
2024-06-10 Add Test_Z_StepperMotor.ino & ROTOR_bench_v0_1.in
2024-06-11 add stepperMotor_test.ino
2024-06-12 Fix bug shipSelect SD card
    [RTC_LCD_SD_PAP.ino]
2024-06-13 Add PAP_UNO & ROTOR_bench_v0_2
2024-06-13 prefix Arduino test files with UNO or MEHA
2024-06-14 fix sriting header in ROTOR_bench_v0_2.ino
2024-07-03 Switching to Python...
2024-07-03 switch to Python
2024-07-03 switch to Python...
2024-07-03 RPi-rotor test
2024-07-08 Create stike.py with dict in /t:p/ROTOR_LAUNCH.txt
2024-07-08 Create strike.py with paramsin tmp/ROTOR_LAUNCH.txt
2024-07-17 MAJ RotorBench_project.odt
2024-07-17 Add Fritzing & Freecad docs
    [ElectricalScheme.fzz, Magnetic ProbePlate.FCStd, OverallPlate.FCStd]
2024-07-17 MAJ Docs
    [MagneticProbePlate.FCStd]
2024-09-09 Buttons for Angle and Zpos
2024-10-08 Migration RPi4 -> RPi5 + fix bug Zpos=0
    [ROTOR_bench.py, Tools.py, strike.py]
2024-10-10 MAJ RotorBench_project.odtUpdate
2024-10-18 First try for the Angle and Zpos buttons
2024-11-13 Fix Zpos 0 always present
    [ROTOR_bench.py, Tools.py, strike.py]
2024-11-13 Fix size of plots when 1, 2 or 3 plots
    [ROTOR_bench.py]
2024-11-19 Update on the material bench afyerRPi5 crash
    [ROTOR_bench.py, Tools.py]
2025-05-11 ROTOR data visualization
2025-05-13 PyQt ROTOR data visualization
